GUIDchen/utp3315tfl-ii-mod/docs/README.md

# 文档索引

| 文档 | 内容 | 适合谁 |
|---|---|---|
| [00-introduction.md](00-introduction.md) | 项目背景、设计取舍、路线图 | 第一次了解本项目 |
| [01-research.md](01-research.md) | 机型规格、内部构造、电路拓扑、已知通病、实测清单 | 想弄懂机器 |
| [02-fan-mod.md](02-fan-mod.md) | 风扇温控方案对比、原理、参数、接线、调试、验收 | 做风扇改造 |
| [03-knob-mod.md](03-knob-mod.md) | 旋钮精度量化、四种方案、10 圈电位器替换与校准 | 做旋钮改造 |
| [04-bom.md](04-bom.md) | 分方案物料清单、参考价、替代料 | 采购 |
| [05-build-and-test.md](05-build-and-test.md) | 工具、拆机、施工、测试记录表、故障排查 | 动手施工 |
| [06-appendix.md](06-appendix.md) | NTC 分压表、引脚、熔丝位、来源 | 查参数 |
| [utp3315tfl-ii-modification-guide.pdf](utp3315tfl-ii-modification-guide.pdf) | 上述内容的 44 页合并版 | 打印/离线阅读 |

> 所有“推断/需实测”处请不要照抄；不同批次的器件与结构可能不同。
