GUIDchen/utp3315tfl-ii-mod/SAFETY.md

# 安全须知

> **这不是“低压小制作”。** UTP3315TFL-II 内有 220 V 市电、4700 µF 高压电容、以及可能带高压的功率管散热器。一次疏忽就可能造成设备损坏、火灾或人身伤害。

## 1. 谁适合做这个改造

适合：

- 有市电作业经验，能区分火线/零线/地线；
- 会用万用表测电压、电阻、通断；
- 有隔离变压器或漏电保护器；
- 能接受“开盖即失去保修”。

不适合：

- 第一次拿烙铁；
- 没有隔离变压器/漏保，且在潮湿、金属台面上作业；
- 只想“插上就用”，不想测量和验收。

不适合也想要效果？只做 **成品 24 V NTC 风扇模块 + 外部接线** 的低风险版本，或请专业人士操作。

## 2. 断电与放电

1. 拔掉电源线，不要只按前面板开关。
2. 等待至少 5 分钟，让 4700 µF 自然泄放。
3. 用万用表 **直流电压档** 测大电容两端，确认 <5 V。
4. 若仍有电压，用 **1 kΩ / 5 W** 电阻跨接放电，再复测。
5. 放电后不要立刻用手摸电容引脚与整流桥。

## 3. 市电侧

- 拆机、走线、固定 NTC 时，手不要同时接触市电侧与次级侧。
- 新增导线不得跨越 220 V 区域；与市电保持 **≥6 mm** 爬电距离。
- 保留原保险丝、原接地、原 110/220 V 选择开关位置；不要改动一次侧。
- 首次上电用隔离变压器/漏保，手不要离开电源开关。
- 上电前检查：没有工具/锡渣/线头遗留在机内，风扇叶片不被线束挡住。

## 4. 散热器可能带电

D1047 的集电极与散热器之间如果有绝缘垫，散热器可能浮空；如果绝缘破损，散热器可能带 raw DC 高压（最高约 38 V，甚至更高）。

- 固定 NTC 前，先用万用表测 **散热器对机箱地/输出地** 的电压。
- 若不为 0 V，必须使用 **绝缘型 NTC**、绝缘垫或导热绝缘胶。
- 不要用裸金属螺钉直接把 NTC 压在带电散热器上。

## 5. 风扇与 24 V 侧

- 风扇是 24 V DC，仍属于低压，但风扇线可能靠近市电；走线要固定、远离一次侧。
- 控制板用尼龙柱固定，底部垫绝缘纸；避免与机箱金属件短路。
- F1 0.5 A 自恢复保险丝不能替代原机保险丝。

## 6. 上电顺序

1. 不装盖，先空载上电，测 5 V、24 V、风扇电压。
2. 确认风扇向外排风，转速随 NTC 变化。
3. 空载测 0–30 V 可调。
4. 带 1 A 负载 10 min，摸散热器/变压器温度。
5. 再带 5 A 负载；装盖后重复 1 A/30 min。
6. 任何焦味、异响、冒烟、跳闸：立即断电，不要用手拔线。

## 7. 责任

本资料基于公开信息与同类机型推断，未获得优利德官方图纸。按本文施工造成的设备损坏、人身伤害、保修失效或数据损失，由施工者自行承担。作者与贡献者不承担任何责任。

如果你不确定某一步，停下来，找有经验的人复核。
