GUIDchen/utp3315tfl-ii-mod/docs/00-introduction.md

# 00 · 项目介绍：为什么做、怎么做、做到哪一步

## 一台“够用”的线性电源，两个天天碰到的问题

UTP3315TFL-II 是一台很适合入门的线性电源：0–30 V / 0–5 A、四位数显、CV/CC 自动切换、变压器加 D1047 的经典结构。它不花哨，但输出干净、坏了也相对好修。

真正天天影响使用的，是两个很小的细节。

**第一，风扇。** 原机用 80 mm、24 V 风扇，上电即全速。评测里说 6 V 时几乎听不见、9 V 已明显、24 V 像小飞机。可它又不能停：机箱很小，风扇同时给 D1047 散热器和变压器散热。于是只有两个选择——忍受噪声，或者做一个“按需散热”的温控。

**第二，电压粗调。** 单圈碳膜电位器只有约 270° 行程，30 V 量程下约 111 mV/°。想设 12.00 V，粗调一碰就跳过几十毫伏，再用 FINE 反复追。用久了碳膜磨损，还会跳变、调不到 0 V——迅维网的维修帖就是换 1 kΩ 电位器解决的。

这两个问题都不影响“能不能用”，但影响“愿不愿意天天用”。这个项目就是针对它们。

## 设计原则

1. **可逆**：保留原风扇、原插头、后面板；控制板可以拆掉恢复原状。
2. **失效安全**：NTC 断线/短路时风扇全速，而不是停转；可选独立温控开关。
3. **不碰主环路**：风扇只改 24 V 供电；旋钮只换同阻值电位器，不改 CV/CC 反馈与设定分压网络。
4. **可测量**：每个改造都有目标值、测试方法和验收表，而不是“感觉更安静了”。
5. **低成本**：风扇控制板约 ¥35–45；10 圈电位器约 ¥18 起。不用开 PCB 也能做。

## 为什么是 NTC + PWM，而不是别的

| 方案 | 为什么不选 / 为什么选 |
|---|---|
| 两档开关（6 V / 24 V） | 便宜，但不随温度变化，仍需手动；只适合“先降噪” |
| 线性调压（运放 + PNP） | 无开关噪声，但 24 V 降到 6 V、0.1 A 时约 1.8 W，要加散热片；曲线调整麻烦 |
| 成品 NTC 调速模块 | 零代码，但 PWM 频率未知、曲线不可调，廉价模块可能啸叫 |
| **ATtiny85 + NTC + 31.25 kHz PWM** | 曲线可编程、双 NTC、失效安全、成本低；31 kHz 不可闻，C8 滤波后风扇得到平滑直流 |

选 MCU 不是为了“炫技”，而是因为风扇曲线需要按机型调：30 ℃ 开始、55 ℃ 全速、最低 25%。用电阻搭出同样的曲线不是不行，但调试成本更高。

## 为什么是 10 圈电位器，而不是编码器

数字设定看起来更“现代”：编码器 + MCU + DAC，分辨率可以做到 1 mV。但它会引入三个新问题：

1. **浮地/地环路**：电源输出地不一定是大地，USB 调试器一插就可能把地环路带进来。
2. **环路稳定性**：DAC 直接替换 WIPER 后，设定节点的阻抗、噪声、上电复位都要重新验证。
3. **不可逆**：要断开原电位器、加继电器切换，失败后恢复麻烦。

10 圈电位器是“最小侵入”的方案：同阻值、同三根线、同分压比，只是把 270° 变成 3600°。分辨率提高约 13 倍，保留原 FINE，失败也能换回原电位器。

## 项目包含什么

- **调研**：机型规格、内部构造、功率链路、CV/CC 拓扑推断、已知通病。
- **风扇**：原理图、双 NTC 曲线、31 kHz PWM + 滤波、失效安全、固件、接线、验收。
- **旋钮**：四种方案对比、10 圈电位器选型、三种安装方式、校准与验收。
- **物料**：分方案 BOM、参考价、渠道、替代料。
- **施工**：拆机、焊接、烧录、测试记录表、故障排查。
- **图纸**：系统框图、两张原理图、机内接线图、旋钮安装剖面（SVG + PNG）。
- **PDF**：44 页合并版，适合打印。

## 当前状态（重要）

**v1.0 是“设计包”，不是“批量实测报告”。**

已完成：电路、BOM、固件、接线、施工与验收流程、图纸、PDF。

尚未汇总：整机风扇电压/电流、V-COARSE 实际阻值、满载温度曲线、改造前后纹波对比、10 圈电位器安装照片。

所以你会看到文中大量“需实测”“推断”“目标值”。这不是偷懒，而是因为不同批次的器件、风扇、电位器可能不同；把不确定的地方标出来，比假装确定更有用。

## 路线图

- **v1.1**：汇总社区实测，补温度—转速、纹波、设定精度曲线。
- **v1.2**：出 PCB（30 × 40 mm，双面，兼容 12/24 V 风扇），提供 Gerber。
- **v1.3**：面板支架/联轴器的 3D 打印文件；12 V 风扇版本。
- **v2.0**：可选隔离 DAC 数字设定，但只作为进阶分支，不替代 10 圈电位器主线。

## 适合谁

- 有一台 UTP3315TFL-II，受够风扇噪声的人；
- 想练手“小 MCU + 传感器 + 功率开关”的爱好者；
- 需要一台安静、可精确设定的第二台电源的维修/嵌入式工程师；
- 愿意提交实测数据，让后来者少踩坑的人。

## 不适合谁

- 第一次拿烙铁、没有市电经验的人；
- 不想测量、只想“照图焊完就用”的人；
- 希望改造后保修仍然有效的人；
- 需要 1 mV 级数字设定、又不想处理浮地/环路的人。

## 名字与授权

项目名 **UTP3315TFL-II MOD**，与优利德无隶属关系。固件/工具用 MIT；文档/图纸/BOM 用 CC BY-SA 4.0。转载请保留来源与署名，不要暗示官方认可。
