GUIDchen/utp3315tfl-ii-mod/hardware/previews/fan-sch-ntc-output.png

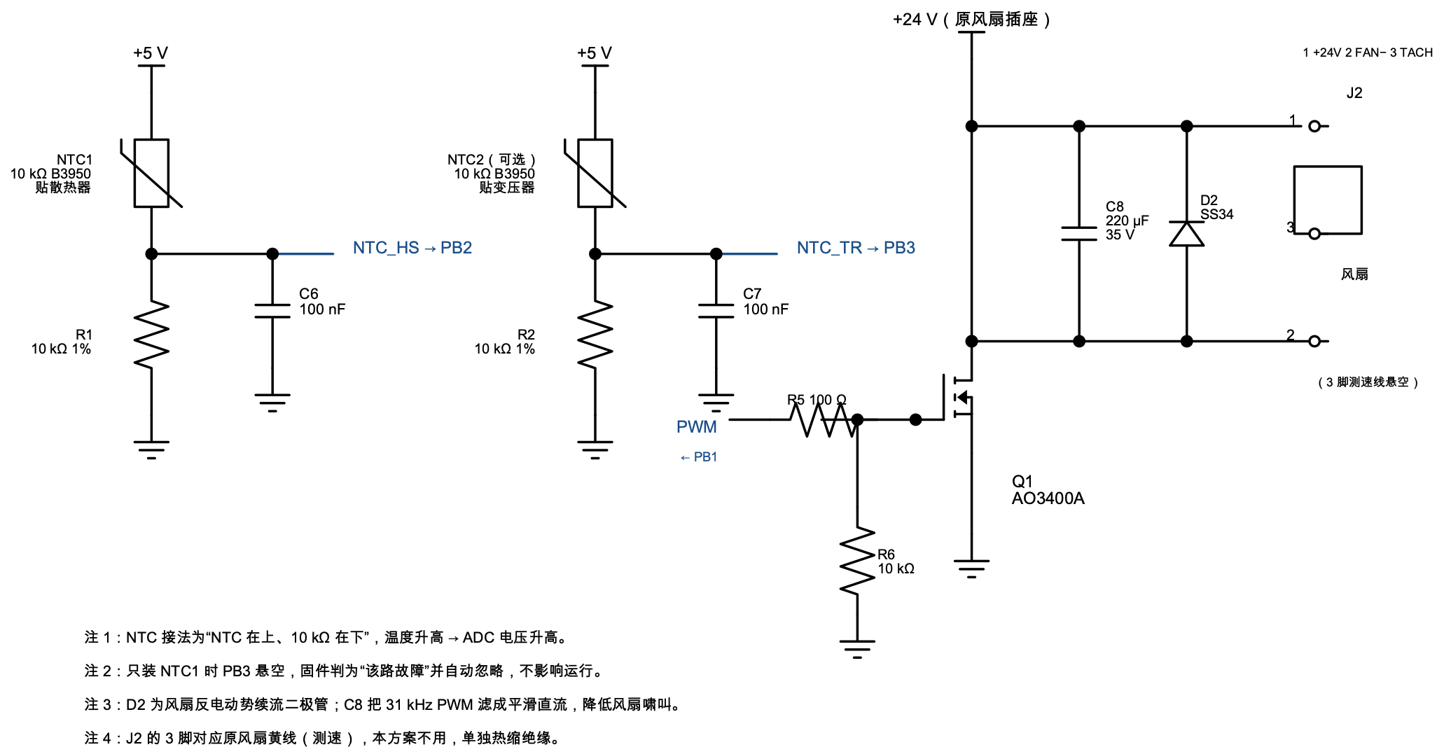
hardware/previews/fan-sch-ntc-output.png
