GUIDchen/utp3315tfl-ii-mod/docs/04-bom.md

# 04 · 物料清单（BOM）

> 价格为 2026 年 7 月国内电商/立创商城参考价，随渠道与批量波动；标注“可选”的可以不买。
> 同一位号在不同方案中可能复用，按表采购即可。

## 1. 风扇温控（推荐方案 B：ATtiny85）

### 1.1 半导体与 IC

| 位号 | 名称 | 规格 | 数量 | 单价 ¥ | 渠道 | 备注 |
|---|---|---|---|---|---|---|
| U1 | 三端稳压 | 78L05，TO-92，5 V/100 mA | 1 | 0.5 | 立创/淘宝 | 可用 78L05ACZ |
| U2 | MCU | ATtiny85-20PU，DIP-8 | 1 | 9 | 立创/淘宝 | 需 8 MHz 内部时钟 |
| — | IC 座 | DIP-8，窄体 | 1 | 0.3 | 立创 | 方便更换/烧录 |
| Q1 | N-MOSFET | AO3400A，SOT-23，30 V/5.7 A | 1 | 0.3 | 立创 | 可用 IRLML2502 |
| D1 | 肖特基 | SS34，40 V/3 A，SMA | 1 | 0.2 | 立创 | 反接保护 |
| D2 | 肖特基 | SS34，40 V/3 A，SMA | 1 | 0.2 | 立创 | 风扇续流 |
| LED1 | 发光二极管 | 3 mm，绿色 | 1 | 0.2 | 淘宝 | 运行指示 |
| LED2 | 发光二极管 | 3 mm，红色 | 1 | 0.2 | 淘宝 | 故障/过温 |

### 1.2 电阻、电容

| 位号 | 名称 | 规格 | 数量 | 单价 ¥ | 备注 |
|---|---|---|---|---|---|
| R1, R2 | 金属膜电阻 | 10 kΩ，1 %，1/4 W | 2 | 0.05 | NTC 下拉 |
| R5 | 金属膜电阻 | 100 Ω，1 %，1/4 W | 1 | 0.05 | 栅极串联 |
| R6 | 金属膜电阻 | 10 kΩ，1 %，1/4 W | 1 | 0.05 | 栅极下拉 |
| R7, R9 | 金属膜电阻 | 1 kΩ，1 %，1/4 W | 2 | 0.05 | LED 限流 |
| R13 | 金属膜电阻 | 10 kΩ，1 %，1/4 W | 1 | 0.05 | RESET 上拉 |
| R17 | 金属膜/绕线 | 470 Ω，1 W | 1 | 0.2 | 78L05 预降压 |
| C1 | 电解电容 | 220 µF/35 V，105 ℃ | 1 | 1.2 | 输入储能 |
| C2 | 电解电容 | 10 µF/16 V | 1 | 0.3 | 5 V 滤波 |
| C3, C4 | 瓷片电容 | 100 nF/50 V，X7R | 2 | 0.1 | 去耦 |
| C6, C7 | 瓷片电容 | 100 nF/50 V，X7R | 2 | 0.1 | NTC 滤波 |
| C8 | 低 ESR 电解 | 220 µF/35 V，105 ℃ | 1 | 1.5 | 风扇 PWM 滤波 |

### 1.3 连接器、结构与耗材

| 位号 | 名称 | 规格 | 数量 | 单价 ¥ | 备注 |
|---|---|---|---|---|---|
| J1 | 接线端子 | 5.08 mm，2P | 1 | 1.0 | 24 V 输入 |
| J2 | XH2.54 座 | 3P，直针 | 1 | 0.5 | 风扇输出 |
| J3, J4 | XH2.54 座 | 2P，直针 | 2 | 0.3 | NTC |
| J5 | 排针 | 2×3，2.54 mm | 1 | 0.3 | ISP |
| F1 | 自恢复保险丝 | 0.5 A/30 V | 1 | 0.3 | 或 500 mA 玻璃管 |
| NTC1 | NTC 热敏 | 10 kΩ，B=3950，1 %，1 m 引线 | 1 | 1.5 | 贴散热器 |
| NTC2 | NTC 热敏 | 同上 | 1 | 1.5 | 可选，贴变压器 |
| — | 万用板 | 5×7 cm 双面镀锡 | 1 | 3 | 或打样 PCB |
| — | 尼龙柱/螺钉 | M3×8，配螺母 | 4 | 0.2 | 固定控制板 |
| — | 硅胶线/热缩管 | 24 AWG，多色 | 1 批 | 5 | 接线 |
| KSD | 温控开关 | KSD9700，70 ℃ 常开，5 A | 1 | 2 | 可选，失效保护 |

**小计：约 ¥35–45（不含工具与 PCB 打样）。**

## 2. 旋钮精度（10 圈电位器）

| 位号 | 名称 | 规格 | 数量 | 单价 ¥ | 渠道 | 备注 |
|---|---|---|---|---|---|---|
| RV1 | 多圈电位器 | 1 kΩ，10 圈，线绕，≥2 W，轴 6 mm | 1 | 18 | 淘宝 | WXD3-13-2W-1K |
| RV1′ | 多圈电位器（高配） | 1 kΩ，10 圈，3590S-2-102L，轴 6.35 mm | 1 | 75 | 立创/Mouser | Bourns，寿命更长 |
| — | 旋钮 | Ø22 mm，6.35 mm 紧定螺钉，带指针 | 1 | 8 | 淘宝 | 配 3590S |
| — | 硅胶线 | 24 AWG，三色，15 cm | 1 批 | 2 | 淘宝 | WIPER 双绞 |
| — | 吸锡带 | 2 mm | 1 | 5 | 淘宝 | 拆焊 |
| — | 阶梯钻/铰刀 | 9.5 mm | 1 | 25 | 五金 | 仅面板安装需要 |
| — | L 支架 + 6 mm 联轴器 | 铝/3D 打印 | 1 | 15 | 淘宝 | 可选，M2 方案 |
| — | 5:1 减速旋钮 | 6 mm 轴 | 1 | 15 | 淘宝 | 可选，M3 方案 |

**小计：约 ¥33（WXD3 + 旋钮 + 线 + 吸锡带）；高配 3590S 约 ¥90。**

> 若实测原电位器是 10 kΩ，把 1 kΩ 换成 10 kΩ 同型号；不要用 1 kΩ 代替 10 kΩ。

## 3. 零代码备选（成品模块）

| 名称 | 规格 | 数量 | 单价 ¥ | 备注 |
|---|---|---|---|---|
| 24 V 风扇温控模块 | NTC 10 kΩ，PWM 输出，≥1 A，频率 ≥20 kHz | 1 | 20 | 问清 PWM 频率 |
| NTC | 10 kΩ，B=3950，1 m | 1 | 1.5 | 贴散热器 |
| XH2.54 转接线 | 3P 公母 | 1 | 5 | 不改原插头 |
| 电解电容 | 220 µF/35 V | 1 | 1.5 | 并联在风扇 |
| 肖特基 | SS34 | 1 | 0.2 | 续流 |

**小计：约 ¥28。**

## 4. 工具（按需）

| 工具 | 用途 | 参考价 ¥ |
|---|---|---|
| 恒温烙铁 + 焊锡 + 助焊剂 | 焊接 | 100–300 |
| 数字万用表 | 电压/电阻/通断 | 80–300 |
| USBasp 或 Arduino as ISP | 烧录 ATtiny85 | 15–50 |
| 示波器（可选） | 看 PWM/输出纹波 | — |
| 红外测温枪/热电偶（可选） | 记录散热器温度 | 50–150 |
| 吸锡带/吸锡器 | 拆电位器 | 10–30 |
| 阶梯钻/铰刀 | 面板开孔 | 25–60 |
| 热风枪/打火机 | 热缩管 | 30–100 |

## 5. 采购建议

- **立创商城**：ATtiny85、AO3400A、SS34、78L05、电阻电容、XH2.54，一次配齐，正品可追溯。
- **淘宝**：NTC 带引线、WXD3 多圈电位器、旋钮、KSD9700、万用板，价格低但注意参数。
- **Bourns 3590S**：假货较多，优先立创/Mouser/Digikey；国产 WXD3 对 hobby 用途足够。
- **NTC**：选 B=3950、1 %、环氧头、引线 1 m；不要买裸玻封的，机械强度差。

CSV 版本见 [hardware/bom.csv](../hardware/bom.csv)。
