GUIDchen/utp3315tfl-ii-mod/hardware/bom.csv

方案 | 位号 | 名称 | 规格 | 数量 | 单价CNY | 渠道 | 备注
风扇温控 | U1 | 三端稳压 | 78L05 TO-92 5V/100mA | 1 | 0.5 | 立创/淘宝
风扇温控 | U2 | MCU | ATtiny85-20PU DIP-8 | 1 | 9.0 | 立创/淘宝 | 需8MHz内部时钟
风扇温控 | - | IC座 | DIP-8 窄体 | 1 | 0.3 | 立创
风扇温控 | Q1 | N-MOSFET | AO3400A SOT-23 30V/5.7A | 1 | 0.3 | 立创 | 可用IRLML2502
风扇温控 | D1 | 肖特基 | SS34 40V/3A SMA | 1 | 0.2 | 立创 | 反接保护
风扇温控 | D2 | 肖特基 | SS34 40V/3A SMA | 1 | 0.2 | 立创 | 风扇续流
风扇温控 | LED1 | LED | 3mm 绿色 | 1 | 0.2 | 淘宝 | 运行指示
风扇温控 | LED2 | LED | 3mm 红色 | 1 | 0.2 | 淘宝 | 故障指示
风扇温控 | R1,R2 | 电阻 | 10kΩ 1% 1/4W | 2 | 0.05 | 立创 | NTC下拉
风扇温控 | R5 | 电阻 | 100Ω 1% 1/4W | 1 | 0.05 | 立创 | 栅极串联
风扇温控 | R6 | 电阻 | 10kΩ 1% 1/4W | 1 | 0.05 | 立创 | 栅极下拉
风扇温控 | R7,R9 | 电阻 | 1kΩ 1% 1/4W | 2 | 0.05 | 立创 | LED限流
风扇温控 | R13 | 电阻 | 10kΩ 1% 1/4W | 1 | 0.05 | 立创 | RESET上拉
风扇温控 | R17 | 电阻 | 470Ω 1W | 1 | 0.2 | 立创 | 78L05预降压
风扇温控 | C1 | 电解 | 220µF/35V 105℃ | 1 | 1.2 | 立创 | 输入储能
风扇温控 | C2 | 电解 | 10µF/16V | 1 | 0.3 | 立创 | 5V滤波
风扇温控 | C3,C4 | 瓷片 | 100nF/50V X7R | 2 | 0.1 | 立创 | 去耦
风扇温控 | C6,C7 | 瓷片 | 100nF/50V X7R | 2 | 0.1 | 立创 | NTC滤波
风扇温控 | C8 | 低ESR电解 | 220µF/35V 105℃ | 1 | 1.5 | 立创 | PWM滤波
风扇温控 | J1 | 接线端子 | 5.08mm 2P | 1 | 1.0 | 立创 | 24V输入
风扇温控 | J2 | XH2.54座 | 3P 直针 | 1 | 0.5 | 立创 | 风扇输出
风扇温控 | J3,J4 | XH2.54座 | 2P 直针 | 2 | 0.3 | 立创 | NTC
风扇温控 | J5 | 排针 | 2x3 2.54mm | 1 | 0.3 | 立创 | ISP
风扇温控 | F1 | 自恢复保险丝 | 0.5A/30V | 1 | 0.3 | 立创 | 或500mA玻璃管
风扇温控 | NTC1 | NTC | 10kΩ B3950 1% 1m引线 | 1 | 1.5 | 淘宝 | 贴散热器
风扇温控 | NTC2 | NTC | 10kΩ B3950 1% 1m引线 | 1 | 1.5 | 淘宝 | 可选，贴变压器
风扇温控 | - | 万用板 | 5x7cm 双面镀锡 | 1 | 3.0 | 淘宝 | 或打样PCB
风扇温控 | - | 尼龙柱/螺钉 | M3x8 配螺母 | 4 | 0.2 | 淘宝 | 固定控制板
风扇温控 | - | 硅胶线/热缩管 | 24AWG 多色 | 1 | 5.0 | 淘宝 | 接线
风扇温控 | KSD | 温控开关 | KSD9700 70℃ 常开 5A | 1 | 2.0 | 淘宝 | 可选失效保护
旋钮改造 | RV1 | 多圈电位器 | 1kΩ 10圈 线绕 2W 6mm轴 | 1 | 18.0 | 淘宝 | WXD3-13-2W-1K
旋钮改造 | RV1' | 多圈电位器 | 1kΩ 10圈 3590S-2-102L 6.35mm轴 | 1 | 75.0 | 立创/Mouser | 高配Bourns
旋钮改造 | - | 旋钮 | Ø22mm 6.35mm 紧定螺钉 | 1 | 8.0 | 淘宝 | 配3590S
旋钮改造 | - | 硅胶线 | 24AWG 三色 15cm | 1 | 2.0 | 淘宝 | WIPER双绞
旋钮改造 | - | 吸锡带 | 2mm | 1 | 5.0 | 淘宝 | 拆焊
旋钮改造 | - | 阶梯钻/铰刀 | 9.5mm | 1 | 25.0 | 五金 | 面板安装需要
旋钮改造 | - | L支架+联轴器 | 铝/3D打印 6mm | 1 | 15.0 | 淘宝 | 可选M2方案
旋钮改造 | - | 减速旋钮 | 5:1 6mm轴 | 1 | 15.0 | 淘宝 | 可选M3方案
成品备选 | - | 温控模块 | 24V NTC 10k PWM ≥1A ≥20kHz | 1 | 20.0 | 淘宝 | 问清PWM频率
成品备选 | - | NTC | 10kΩ B3950 1m | 1 | 1.5 | 淘宝
成品备选 | - | 转接线 | XH2.54 3P 公母 | 1 | 5.0 | 淘宝 | 不改原插头
成品备选 | - | 电解 | 220µF/35V | 1 | 1.5 | 立创 | 并联风扇
成品备选 | - | 肖特基 | SS34 | 1 | 0.2 | 立创 | 续流
