GUIDchen/utp3315tfl-ii-mod/hardware/previews/fan-wiring.png

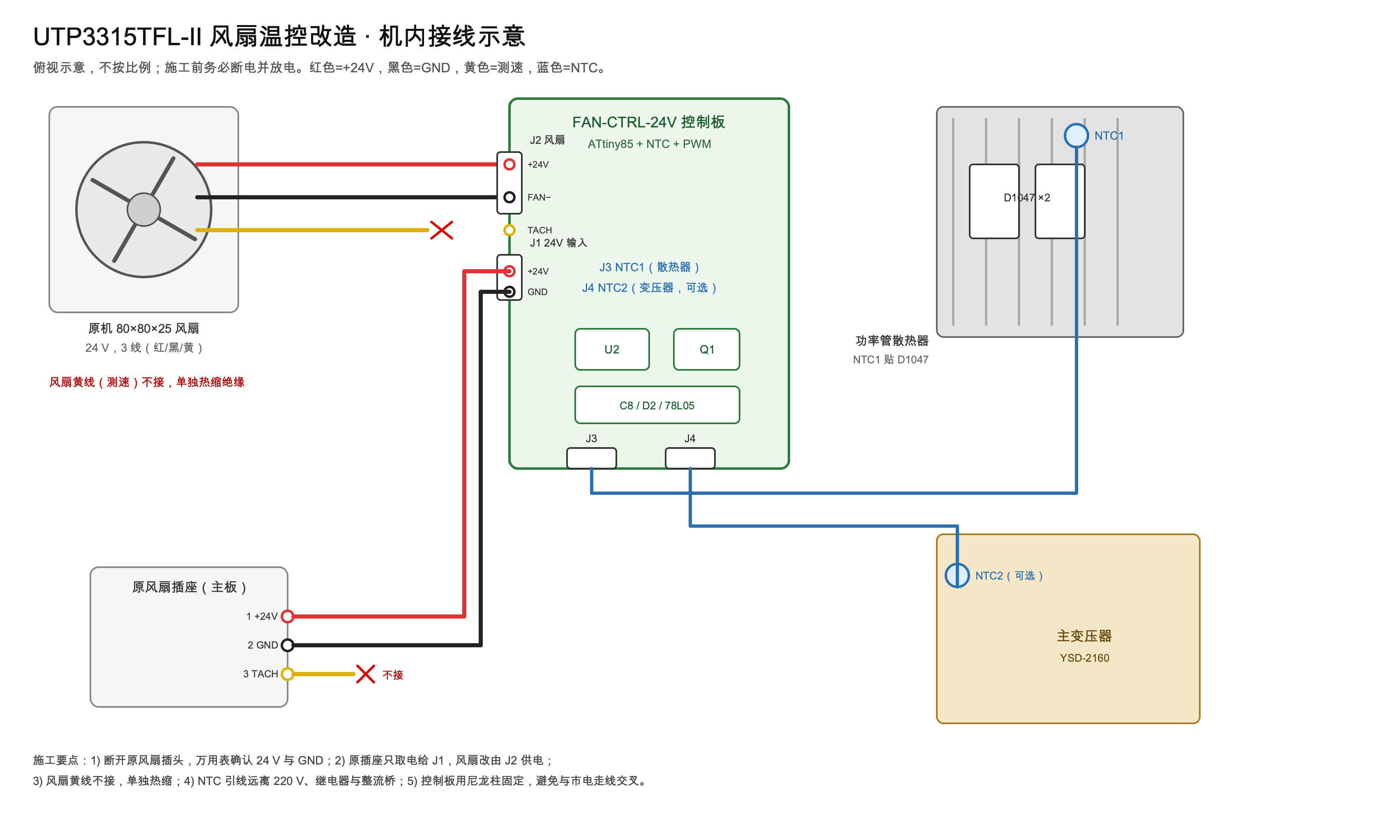
hardware/previews/fan-wiring.png
