GUIDchen/utp3315tfl-ii-mod/docs/05-build-and-test.md

# 05 · 施工、调试与验收

## 1. 安全

> 机内有 **220 V 市电** 与 **4700 µF 高压电容**。断电后电容仍可能存电。

1. 拔掉电源线，等待至少 5 min。
2. 用万用表直流档测 4700 µF 两端，确认 <5 V；必要时用 1 kΩ/5 W 电阻放电。
3. 拆机时一只手不要同时接触市电侧与次级侧。
4. 首次上电用隔离变压器/漏保，手不要离开电源开关。
5. 改造后所有市电走线保持原样，新增线不得跨越 220 V 区域；爬电距离 ≥6 mm。
6. 开盖即失去保修。

## 2. 工具与材料

- 恒温烙铁（300–350 ℃）、焊锡、助焊剂、吸锡带；
- 数字万用表、通断/二极管档；
- USBasp 或 Arduino as ISP；
- 斜口钳、镊子、热缩管、热风枪；
- 尼龙柱、M3 螺钉、扎带；
- 可选：示波器、红外测温枪、阶梯钻。

## 3. 开盖前记录

先填这张表，后面所有判断都靠它：

| 项目 | 实测值 | 备注 |
|---|---|---|
| 风扇插头针数/颜色 |  | 红/黑/黄 |
| 风扇电压（上电） |  V | 万用表 |
| 风扇电流 |  mA | 串表或钩表 |
| 风扇尺寸 |  mm | 80×80×25？ |
| 原风扇插座 1/2/3 定义 |  | +24 V/GND/TACH？ |
| V-COARSE 阻值 |  Ω | 挑开一端 |
| V-FINE 阻值 |  Ω |  |
| 面板开孔直径 |  mm |  |
| 面板到显示板间距 |  mm |  |
| 满载 30 min 散热器温度 |  ℃ | 红外枪 |

## 4. 拆机

1. 拔电源线，放电。
2. 翻到底部，拧下 4 颗固定螺钉（注意长短可能不同，记位置）。
3. 取下上盖/侧板；有的批次是整体 U 形壳，需从后部向前推。
4. 拔下风扇 3 针插头；拔下显示板 8 芯排线（如有卡扣先解锁）。
5. 拍照记录：变压器引线、继电器、显示板排线方向、电位器线序。
6. 不要拉扯变压器引线；不要碰 4700 µF 引脚。

## 5. 焊控制板

### 5.1 建议布局（5×7 cm 万用板）

- 左侧：J1、F1、D1、C1、R17、78L05；
- 中间：U2 DIP-8 座、C4；
- 右侧：Q1、D2、C8、J2；
- 下侧：J3/J4、R1/R2/C6/C7；
- 上侧：J5 ISP。

布线要点：

- 78L05 的输入/输出/地各留一条粗一点的铜线；
- C4 尽量贴近 U2 的 8/4 脚；
- Q1 源极到 GND、C8 负极到 GND 用短而粗的线；
- NTC 分压节点到 U2 的 PB2/PB3 线尽量短，远离 Q1 漏极与风扇线；
- 风扇大电流回路（+24 V → 风扇 → Q1 → GND）不要与 NTC/ADC 地共用一段细线，单点接地到 J1 GND。

### 5.2 焊接顺序

1. 先焊矮元件：电阻、二极管、IC 座、瓷片电容；
2. 再焊 78L05、电解电容、MOSFET；
3. 最后焊接插件：端子、XH 座、排针；
4. 焊完用万用表测：
   - +5 V 对 GND 不短路；
   - +24 V 对 GND 不短路；
   - Q1 漏-源不短路；
   - NTC 分压节点对 5 V/GND 不短路。

## 6. 烧录固件

### 6.1 环境

1. Arduino IDE 安装 **ATTinyCore**：
   - 文件 → 首选项 → 附加开发板管理器网址填 `http://drazzy.com/package_drazzy.com_index.json`；
   - 开发板管理器搜索 “ATtinyCore” 安装。
2. 开发板选择：
   - Board: **ATtiny25/45/85**；
   - Chip: **ATtiny85**；
   - Clock: **8 MHz (internal)**；
   - BOD: **2.7 V**；
   - Programmer: **USBasp** 或 **Arduino as ISP**。
3. 先 **Burn Bootloader**（实际是烧熔丝，把出厂 1 MHz 改成 8 MHz），再 **Upload**。

### 6.2 ISP 接线（ATtiny85 DIP-8）

| ISP 6 针 | ATtiny85 引脚 |
|---|---|
| MISO | PB1（6 脚） |
| VCC | 8 脚 |
| SCK | PB2（7 脚） |
| MOSI | PB0（5 脚） |
| RESET | PB5（1 脚） |
| GND | 4 脚 |

> PB2 上接着 NTC 分压（10 kΩ），一般不影响烧录；若报错，临时拔掉 NTC1 或 R1。

### 6.3 烧录后自检

- 上电，运行 LED 常亮；
- 用手捏 NTC，风扇应在几秒内升速；
- 拔掉 NTC，风扇全速，故障 LED 闪烁；
- 断电重启，风扇先全速 0.8 s（启动“踢一脚”），再降到当前温度对应的转速。

## 7. 安装控制板与 NTC

1. 在底板空白处选位置：远离 220 V、远离整流桥、不被风扇叶片扫到。
2. 用 4 个尼龙柱 + M3 螺钉固定；控制板下方垫一层绝缘纸/青稞纸。
3. NTC1：
   - 位置：D1047 附近、散热器中部；
   - 方法：M3 螺钉压住 NTC 头部（加绝缘粒），或导热环氧粘接；
   - 若散热器带电，必须用绝缘垫/绝缘型 NTC；
   - 引线沿机箱边缘走，远离 220 V。
4. NTC2（可选）：贴在变压器线包侧面，用 Kapton 胶带固定；不要贴在引线焊点或一次侧。
5. 按接线表接 J1/J2/J3/J4；线长留 5 cm 余量，扎带固定。

## 8. 更换电压电位器

1. 拆下显示板，拍照记录 4 只电位器线序。
2. 用吸锡带 + 烙铁拆下 V-COARSE；不要硬拽。
3. 测原电位器端到端阻值，确认新电位器一致。
4. 按 [03-knob-mod.md](03-knob-mod.md) 选择 M1/M2/M3 安装。
5. 飞线焊到原焊盘；WIPER 线双绞。
6. 上电前用万用表确认：
   - 顺时针旋转，WIPER 对 CW 电阻平滑变化；
   - 没有对地/对 5 V 短路。

## 9. 调试

### 9.1 风扇台架

| 步骤 | 操作 | 预期 |
|---|---|---|
| 1 | J1 接 24 V/0.5 A 限流 | 空载电流 <20 mA |
| 2 | 测 U1 输出 | 5.0 V ±0.1 V |
| 3 | 接风扇，室温 | J2 电压 5.5–6.5 V，风扇能启动 |
| 4 | 手捏 NTC1 | 电压逐渐升到 24 V |
| 5 | 拔 NTC1 | 立即全速，故障灯闪 |
| 6 | 短接 NTC1 | 全速，故障灯闪 |

### 9.2 整机

1. 不装盖，通电，确认风扇向外排风。
2. 空载设 12 V，带 1 A 负载 10 min，摸散热器温度。
3. 带 5 A 负载（用大功率电阻/电子负载）10 min，记录散热器与变压器温度。
4. 用示波器 AC 耦合测输出纹波，与改造前对比。
5. 装盖，重复 1 A/30 min。

## 10. 测试记录表

### 10.1 风扇

| 散热器温度 ℃ | 目标占空比 | J2 平均电压 V | 听感/转速 | 备注 |
|---|---|---|---|---|
| 25 | 25 % |  |  |  |
| 30 | 25 % |  |  |  |
| 35 | 40 % |  |  |  |
| 40 | 55 % |  |  |  |
| 45 | 70 % |  |  |  |
| 50 | 85 % |  |  |  |
| 55 | 100 % |  |  |  |
| NTC 拔掉 | 100 % |  |  |  |

### 10.2 输出

| 项目 | 改造前 | 改造后 | 判定 |
|---|---|---|---|
| 空载纹波 mVrms |  |  | ≤ +10 % |
| 5 A 纹波 mVrms |  |  | ≤ +10 % |
| 12 V/1 A 负载调整率 mV |  |  | 不劣化 |
| 满载 30 min 散热器 ℃ |  |  | ≤ +5 ℃ |
| 风扇 0.5 m 噪声 |  |  | 明显下降 |

### 10.3 旋钮

| 设定 | 显示值 | 万用表值 | 误差 mV | 判定 |
|---|---|---|---|---|
| 0 V |  |  |  | <10 |
| 5 V |  |  |  | ≤20 |
| 12 V |  |  |  | ≤20 |
| 24 V |  |  |  | ≤30 |
| 30 V |  |  |  | ≤40 |
| 回程 0 V |  |  |  | <10 |
| 敲击跳变 |  |  |  | <20 |

## 11. 故障排查

| 现象 | 检查 | 处理 |
|---|---|---|
| 上电无 5 V | F1、D1、R17、78L05 引脚 | 换件；测输入是否 24 V |
| 风扇不转 | J2 电压、Q1 栅极 PWM、风扇好坏 | 提高 DUTY_MIN；换 Q1；直连 24 V 试风扇 |
| 风扇常全速 | NTC 分压、ADC 焊点、固件 | 测 PB2/PB3 电压；重烧 |
| 低速抖动 | 风扇启动转矩、C8 | DUTY_MIN 提到 96–128；换低启动电压风扇 |
| 啸叫 | PWM 频率、C8、风扇共振 | 加 22 µH 电感；改 25 kHz；换风扇 |
| 输出噪声变大 | 地线、NTC 走线 | 单点接地；NTC 线远离反馈；加 100 nF |
| 烧录失败 | SCK 负载、接线 | 拔 NTC1；检查 ISP 线序；降速 |
| 旋钮方向反 | CCW/CW 接反 | 对调 1/3 |
| 调不到 0 V | CCW 端、电位器阻值 | 检查接线；换同阻值 |
| 显示与万用表差 | V 校准 | 微调主板 V 校准电位器（先标记） |

## 12. 复装与维护

1. 确认所有线束远离风扇叶片与散热器。
2. 装盖前通电 10 min，摸一下新增线/控制板温度。
3. 装盖，拧螺钉时不要压到线。
4. 每 3–6 个月吹一次灰尘；NTC 表面若积灰，响应会变慢。
5. 若长期满载，建议同时升级散热器（ph0en1x 文章有详细方案），风扇温控只是降噪，不增加散热能力。
