GUIDchen/utp3315tfl-ii-mod/(notices)

Notices in the files:
README.md:
License: MIT
Docs: CC BY-SA 4.0
